robotahmid07-debug/WRO-2026-Future-Engineers-Team-Obsidian/README.md

# WRO-2026-Future-Engineers-Team-Obsidian
Official open-source repository for Team Obsidian (Bangladesh) competing in the 2026 World Robot Olympiad (WRO) Future Engineers category.

Hi,
We are Team obsidian.

in WRO 2026 we created an optimized autonomous car
