robotahmid07-debug/WRO-2026-Future-Engineers-Team-Obsidian/3d Models/LegoBevelGear-LegoBevelGearPart.SLDPRT

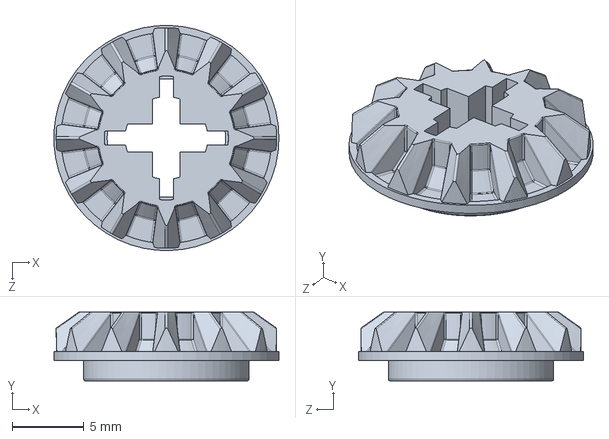
[picture p1: CAD file, 2026-08-11]
3d Models/LegoBevelGear-LegoBevelGearPart.SLDPRT
15.7 x 4.80 x 15.7 mm
