robotahmid07-debug/WRO-2026-Future-Engineers-Team-Obsidian/3d Models/2nd floor.STL

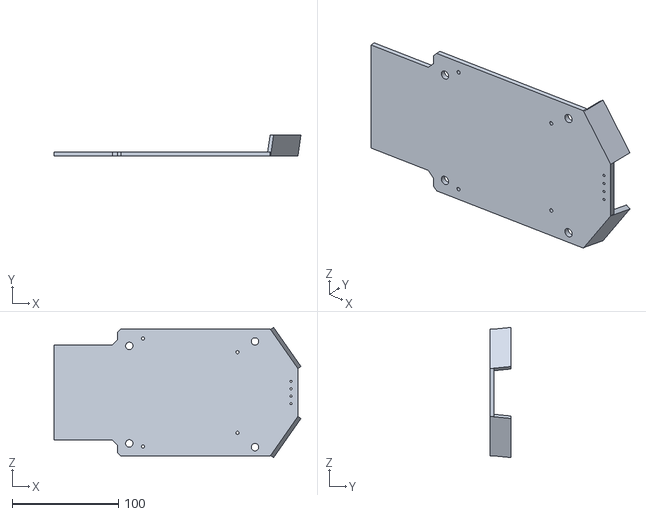
[picture p2: CAD file, 2026-08-08]
3d Models/2nd floor.STL
232.9 x 20.0 x 122.8
