robotahmid07-debug/WRO-2026-Future-Engineers-Team-Obsidian/3d Models/BackWheelAxlePartPocket.STL

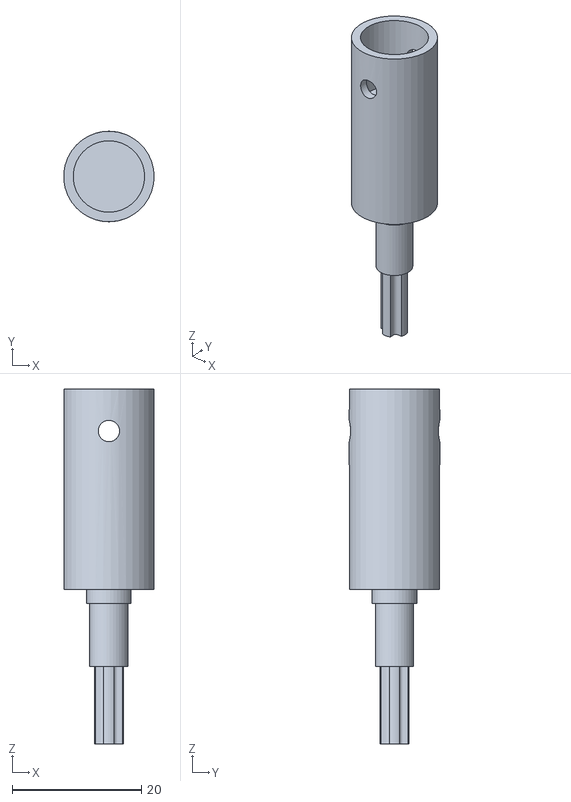
[picture p3: CAD file, 2026-08-08]
3d Models/BackWheelAxlePartPocket.STL
14.0 x 14.0 x 54.9
