robotahmid07-debug/WRO-2026-Future-Engineers-Team-Obsidian/3d Models/FrontWheelAxleLeftBody2.STL

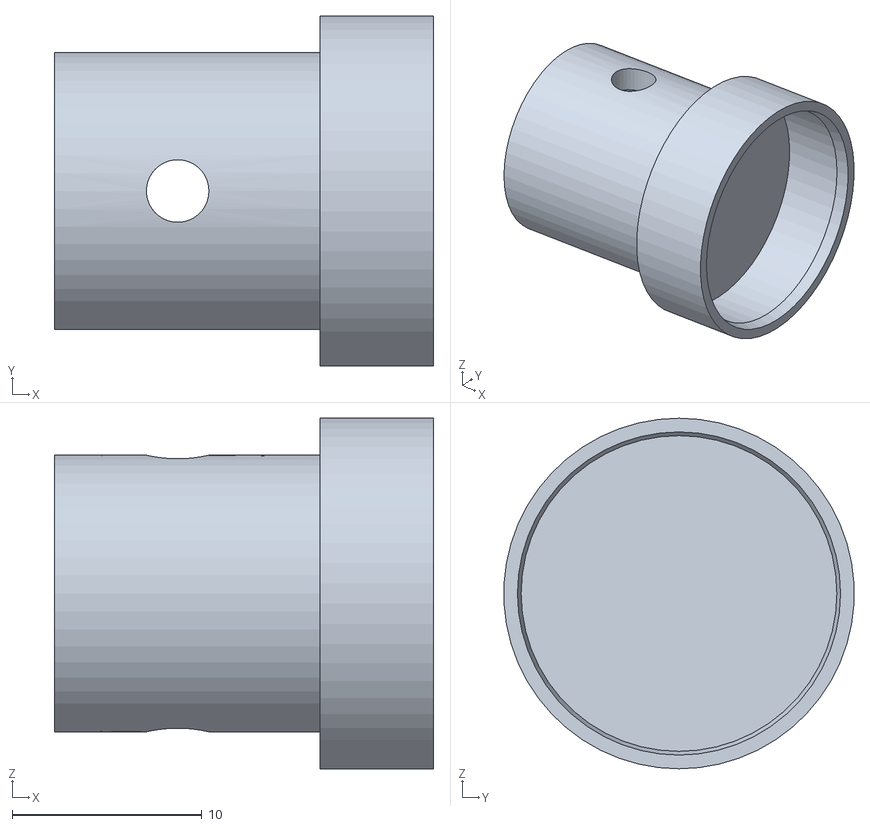
[picture p5: CAD file, 2026-08-08]
3d Models/FrontWheelAxleLeftBody2.STL
20.0 x 18.5 x 18.5
