robotahmid07-debug/WRO-2026-Future-Engineers-Team-Obsidian/3d Models/LegoDifferentialGearPart.STL

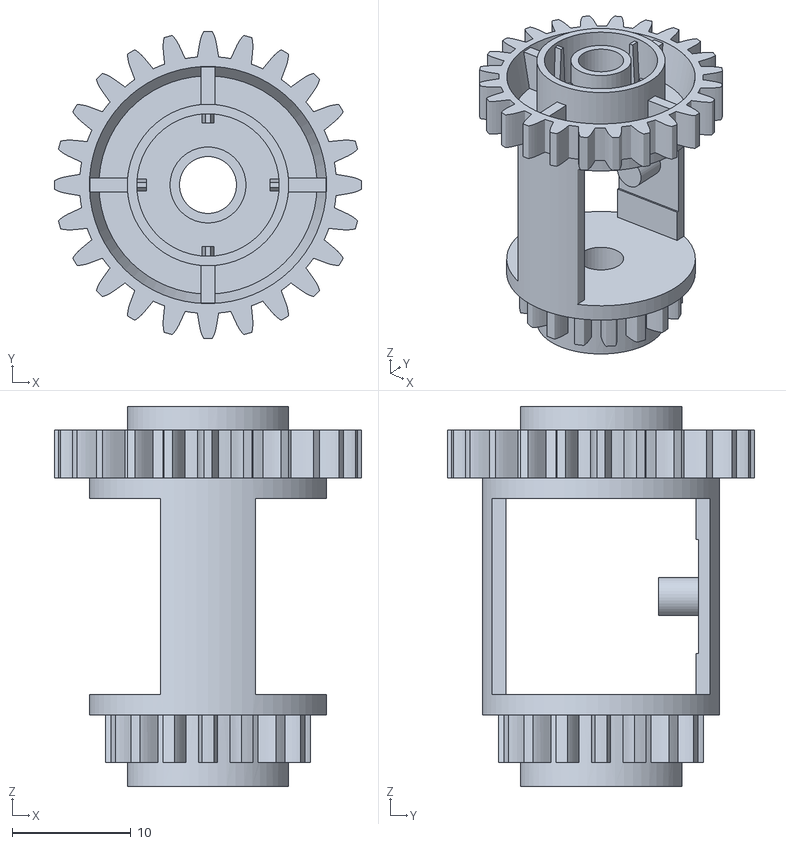
[picture p6: CAD file, 2026-08-07]
3d Models/LegoDifferentialGearPart.STL
25.9 x 25.9 x 32.0
