robotahmid07-debug/WRO-2026-Future-Engineers-Team-Obsidian/3d Models/gear cover.STL

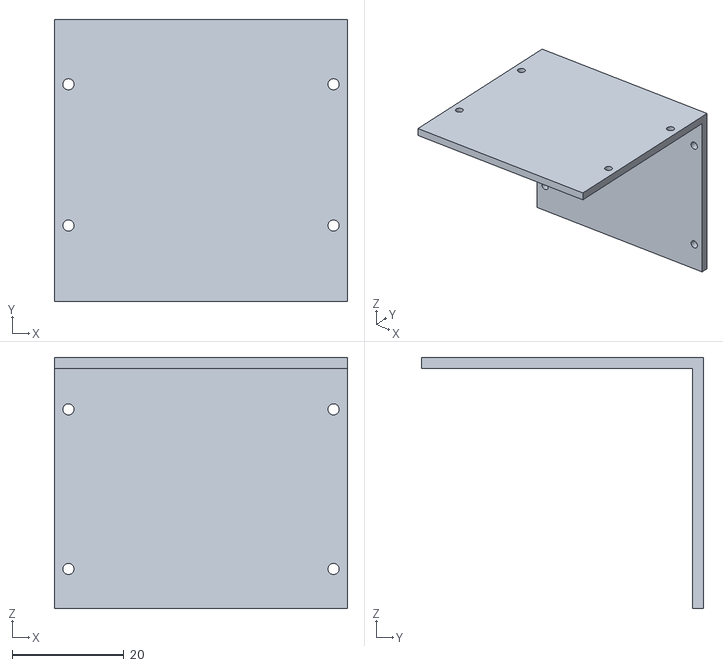
[picture p7: CAD file, 2026-08-07]
3d Models/gear cover.STL
52.5 x 50.6 x 45.0
