robotahmid07-debug/WRO-2026-Future-Engineers-Team-Obsidian/3d Models/ChassisPart.STL

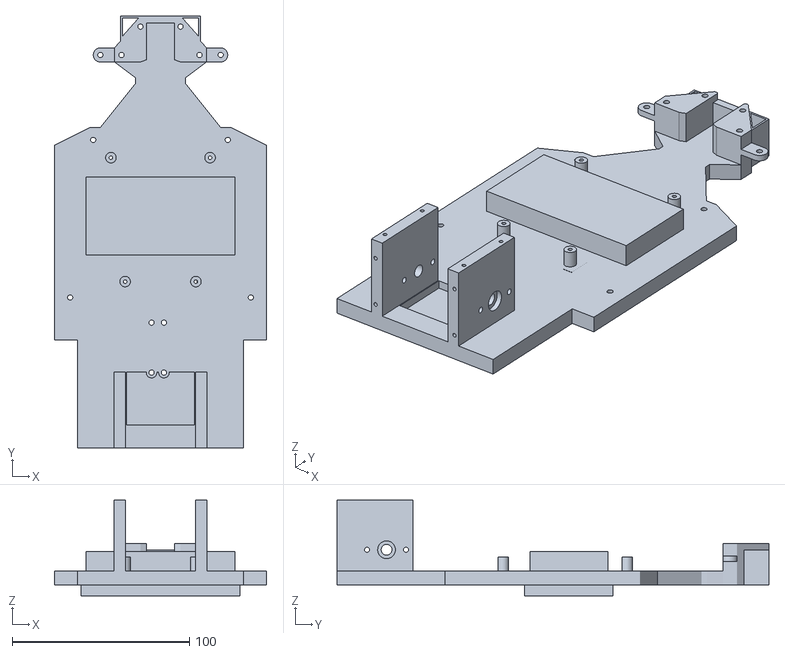
[picture p8: CAD file, 2026-08-07]
3d Models/ChassisPart.STL
120.0 x 244.0 x 54.0
