robotahmid07-debug/WRO-2026-Future-Engineers-Team-Obsidian/3d Models/huskey lens holder 16deg.STL

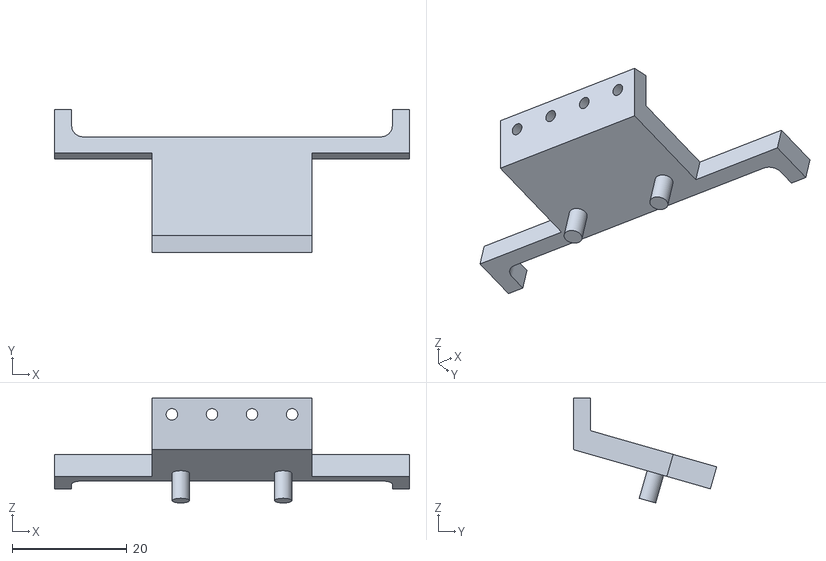
[picture p9: CAD file, 2026-08-07]
3d Models/huskey lens holder 16deg.STL
62.0 x 25.0 x 18.3
