robotahmid07-debug/WRO-2026-Future-Engineers-Team-Obsidian/3d Models/WheelLinkageBottomLeftPart.STL

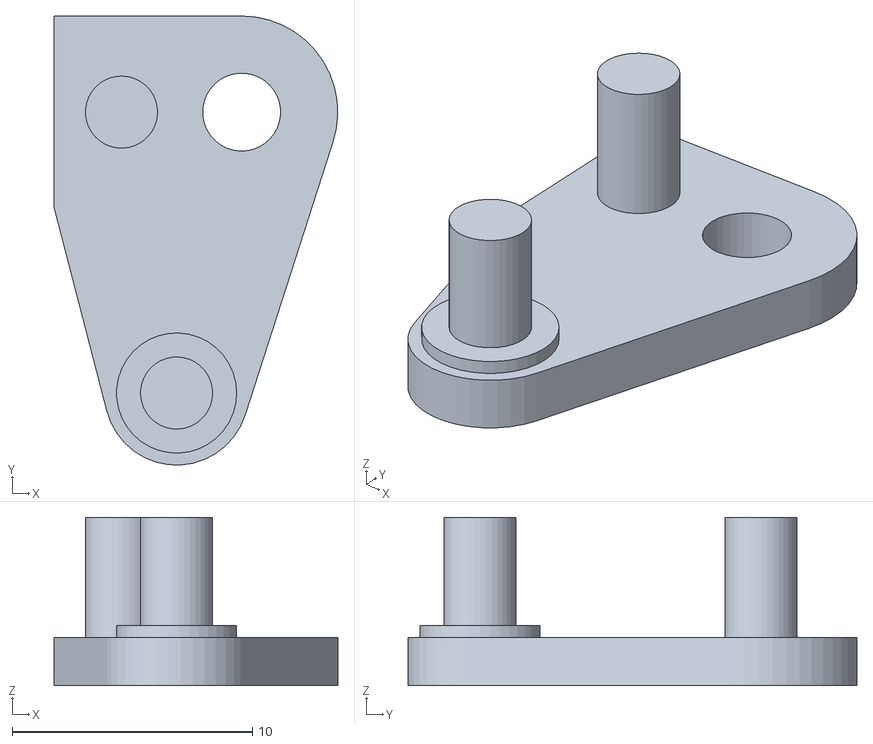
[picture p10: CAD file, 2026-08-07]
3d Models/WheelLinkageBottomLeftPart.STL
11.8 x 18.7 x 7.00
