robotahmid07-debug/WRO-2026-Future-Engineers-Team-Obsidian/3d Models/TransferLinkageLeft-TransferLinkageLeftPart.STL

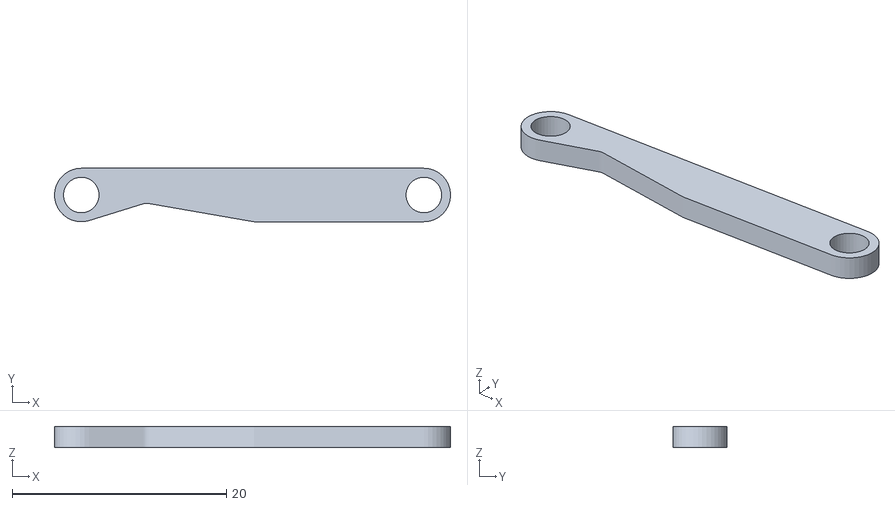
[picture p11: CAD file, 2026-08-07]
3d Models/TransferLinkageLeft-TransferLinkageLeftPart.STL
37.0 x 5.00 x 2.00
