robotahmid07-debug/WRO-2026-Future-Engineers-Team-Obsidian/3d Models/FrontWheelAxleRightBody1.STL

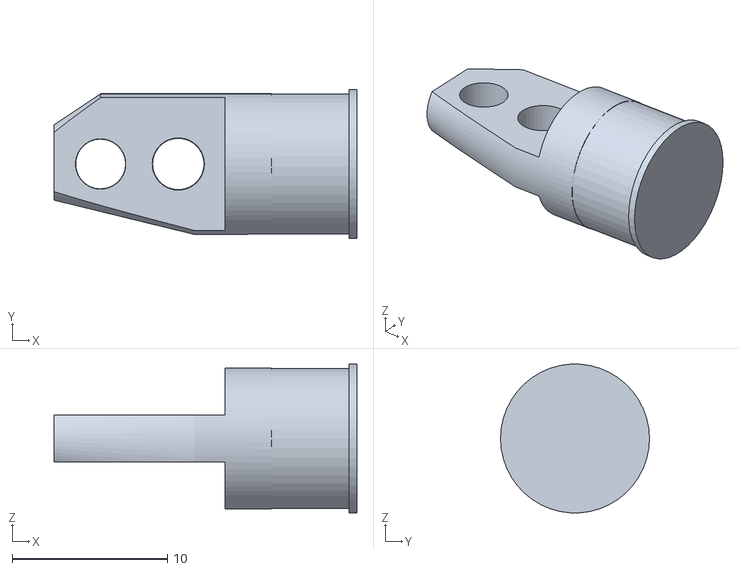
[picture p13: CAD file, 2026-08-07]
3d Models/FrontWheelAxleRightBody1.STL
19.5 x 9.59 x 9.57
