robotahmid07-debug/WRO-2026-Future-Engineers-Team-Obsidian/3d Models/huskey lens holder 12deg.STL

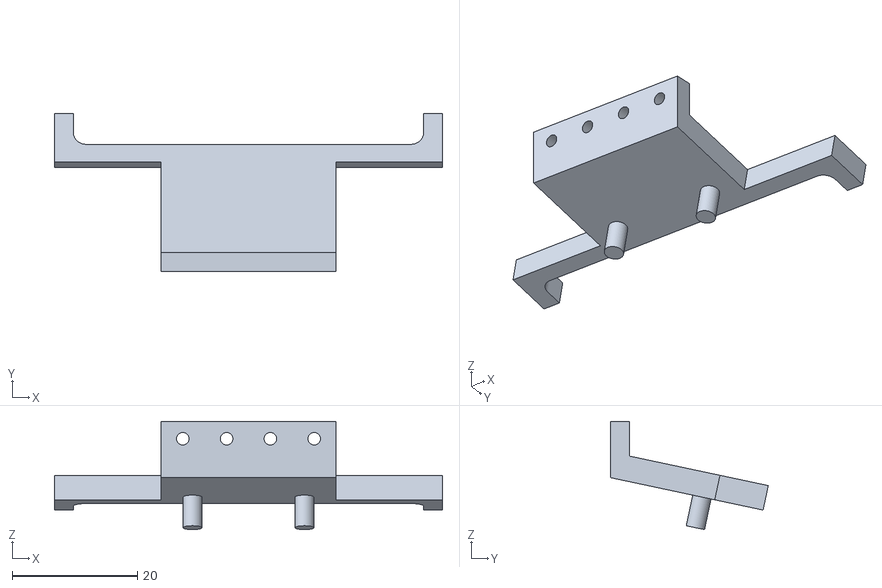
[picture p14: CAD file, 2026-08-07]
3d Models/huskey lens holder 12deg.STL
62.0 x 25.2 x 17.3
