robotahmid07-debug/WRO-2026-Future-Engineers-Team-Obsidian/3d Models/WheelLinkageTopRightPart.STL

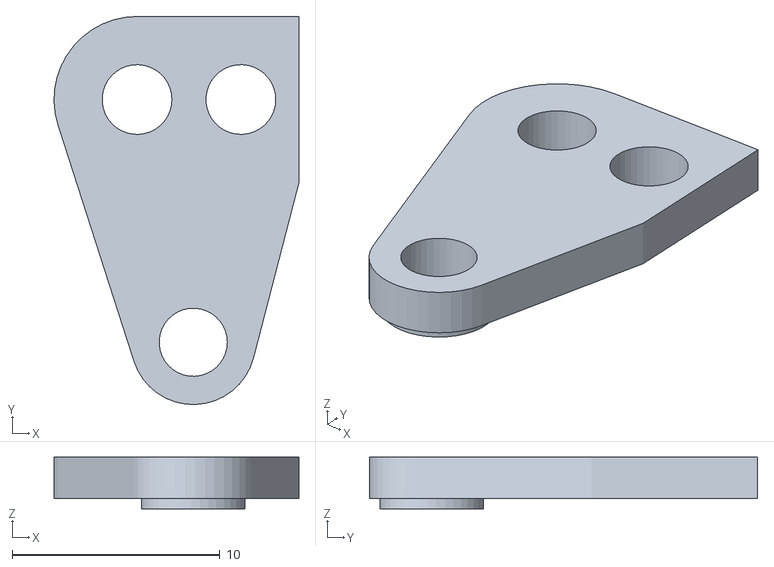
[picture p15: CAD file, 2026-08-07]
3d Models/WheelLinkageTopRightPart.STL
11.8 x 18.7 x 2.50
