robotahmid07-debug/WRO-2026-Future-Engineers-Team-Obsidian/3d Models/MotorGearPart.STL

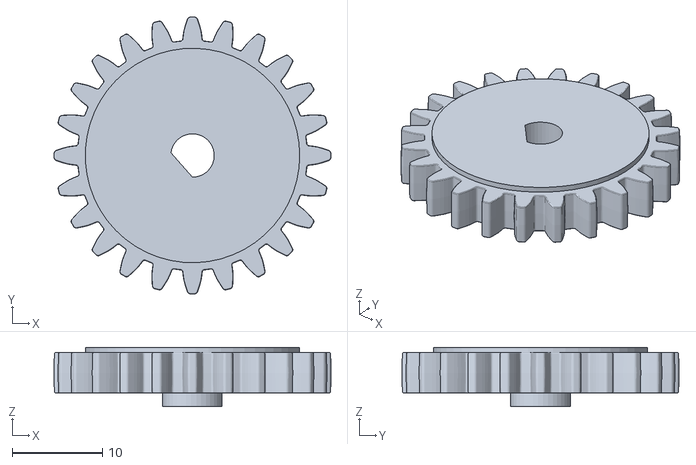
[picture p16: CAD file, 2026-08-07]
3d Models/MotorGearPart.STL
30.6 x 30.6 x 6.57
