robotahmid07-debug/WRO-2026-Future-Engineers-Team-Obsidian/3d Models/FrontWheelAxleLeftBody1.STL

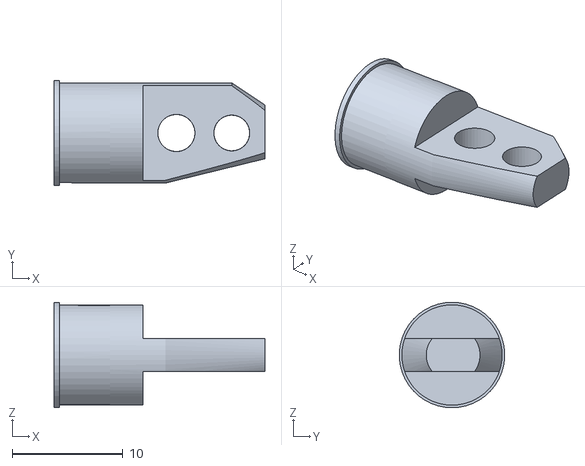
[picture p17: CAD file, 2026-08-07]
3d Models/FrontWheelAxleLeftBody1.STL
19.1 x 9.50 x 9.52
