robotahmid07-debug/WRO-2026-Future-Engineers-Team-Obsidian/3d Models/Motor Hub.STL

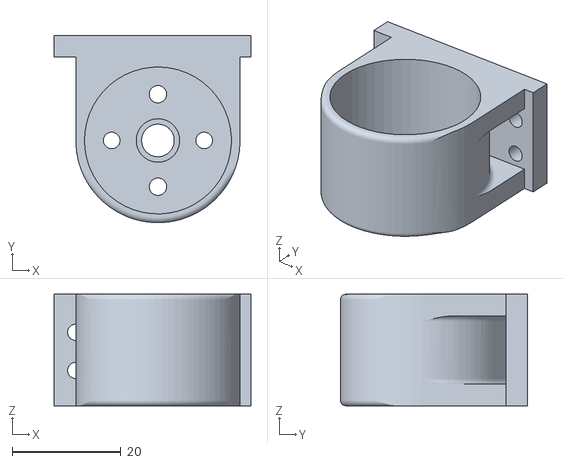
[picture p18: CAD file, 2026-08-07]
3d Models/Motor Hub.STL
36.2 x 34.4 x 20.5
