robotahmid07-debug/WRO-2026-Future-Engineers-Team-Obsidian/3d Models/Battery cover.STL

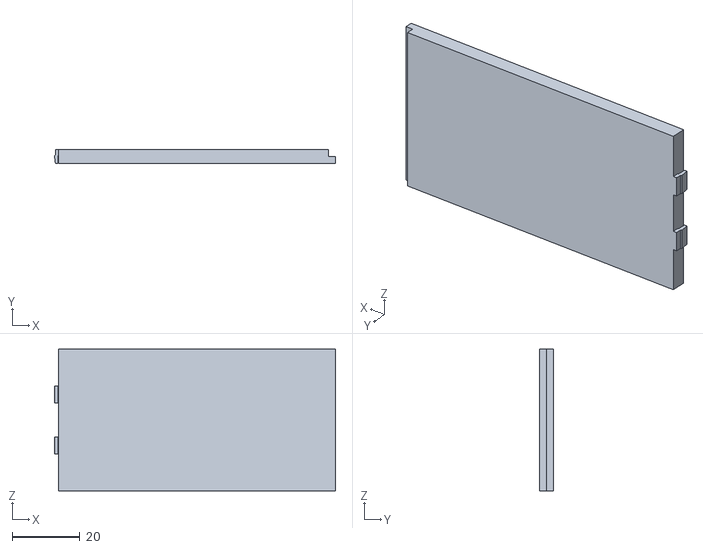
[picture p19: CAD file, 2026-08-07]
3d Models/Battery cover.STL
83.2 x 4.00 x 42.0
