robotahmid07-debug/WRO-2026-Future-Engineers-Team-Obsidian/3d Models/2nd floor piller.STL

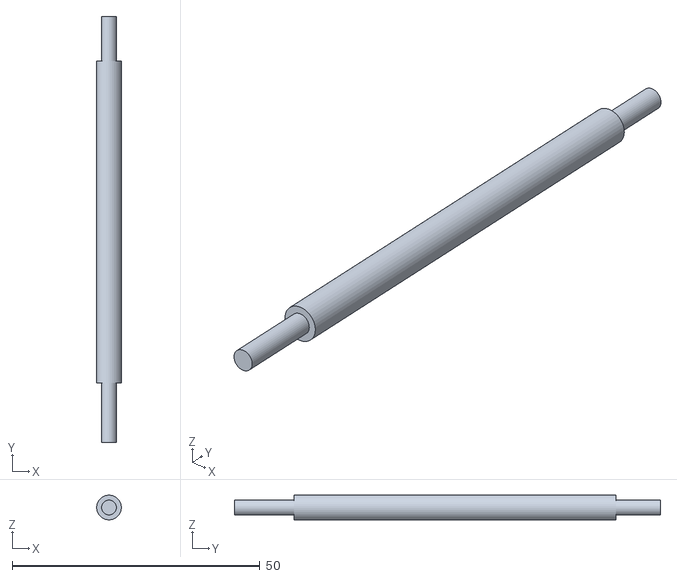
[picture p20: CAD file, 2026-08-07]
3d Models/2nd floor piller.STL
5.00 x 86.0 x 5.00
