robotahmid07-debug/WRO-2026-Future-Engineers-Team-Obsidian/3d Models/FrontCoverPart.STL

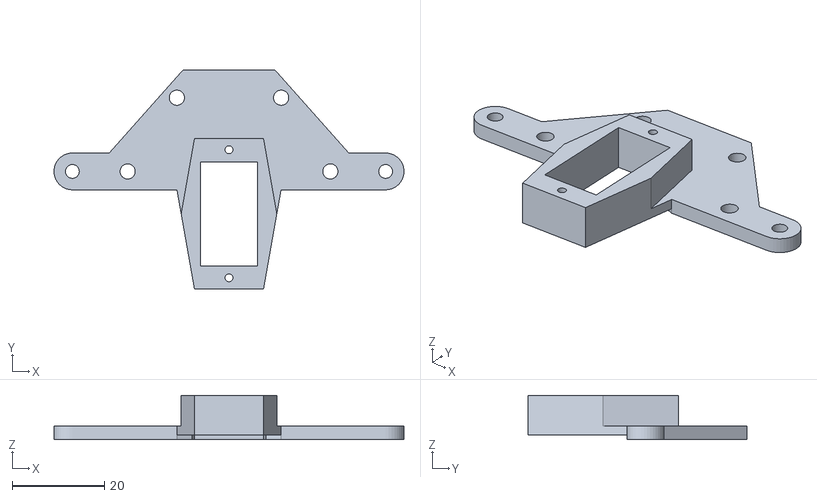
[picture p21: CAD file, 2026-08-07]
3d Models/FrontCoverPart.STL
76.0 x 47.5 x 9.65
