robotahmid07-debug/WRO-2026-Future-Engineers-Team-Obsidian/3d Models/back bearing cover.STL

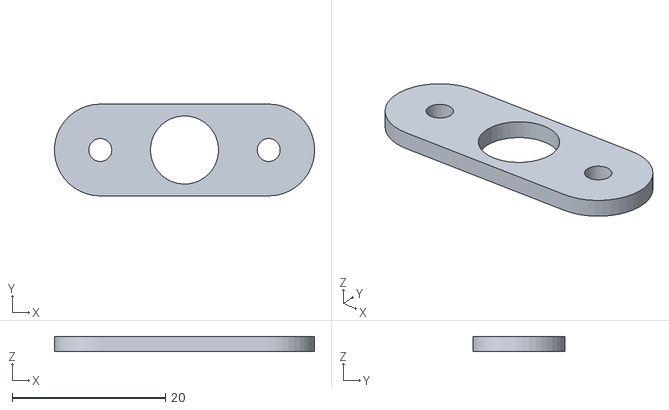
[picture p22: CAD file, 2026-08-07]
3d Models/back bearing cover.STL
34.0 x 12.0 x 2.00
