robotahmid07-debug/WRO-2026-Future-Engineers-Team-Obsidian/3d Models/TBoneLinkageBottomPart.STL

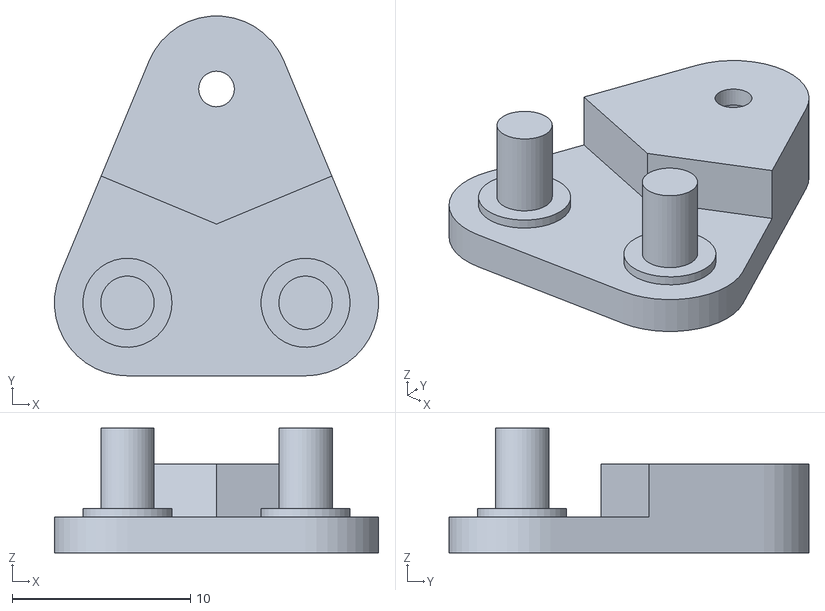
[picture p23: CAD file, 2026-08-07]
3d Models/TBoneLinkageBottomPart.STL
18.2 x 20.2 x 7.00
