robotahmid07-debug/WRO-2026-Future-Engineers-Team-Obsidian/3d Models/TBoneLinkageTopPart.STL

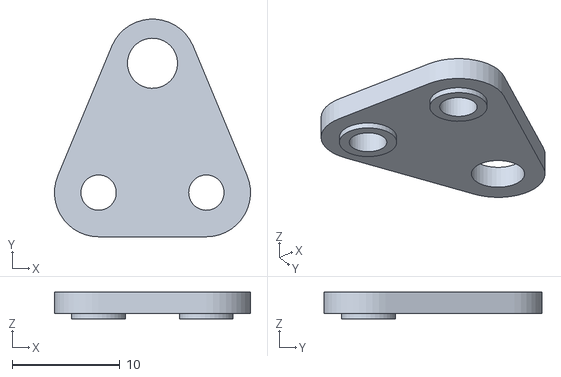
[picture p24: CAD file, 2026-08-07]
3d Models/TBoneLinkageTopPart.STL
18.2 x 20.2 x 2.50
