robotahmid07-debug/WRO-2026-Future-Engineers-Team-Obsidian/(list of files, cad)

Other CAD files:
3d Models/LegoBevelGearPart.STL
3d Models/WheelLinkageBottomRightPart.STL
3d Models/WheelLinkageTopLeftPart.STL
3d Models/TransferLinkageRightPart.STL
