robotahmid07-debug/WRO-2026-Future-Engineers-Team-Obsidian/config/system_prompt_matrix.yaml

# ==========================================
# Written by Tahmed Ahmed
# Update date : 26-7-26
# ==========================================
system_prompt_matrix:
  version: "2026.3"
  competition: "WRO Future Engineers"

  # ==========================================
  # 0. CHALLENGE SELECTION
  # ==========================================
  # This is optional – if set, it overrides the hardware switch.
  # Leave commented to use the hardware switch (GPIO 22).
  # active_challenge: "open"   # "open" or "obstacle"

  # ==========================================
  # 1. ZONE & POSE MANAGEMENT
  # ==========================================
  zone_management:
    open_challenge:
      save_start_point: True
      use_parking_slot: False
      start_pose_registration:
        method: "LIDAR_WALL_DISTANCES_AND_ODOMETRY"
        save_at_boot: True
        pose_vector: [x_start, y_start, theta_start]
      finish_behavior:
        action: "CONTROLLED_STOP_AT_START_ZONE"
        trigger: "COMPLETED_3_LAPS_AND_CROSS_START_LINE"
        deceleration_profile: "SMOOTH_BRAKE"

    obstacle_challenge:
      save_start_point: True
      use_parking_slot: True
      parking_slot_registration:
        save_initial_bay_geometry: True
        save_at_boot: True
        bay_bounding_box: [x_min, x_max, y_min, y_max]
      finish_behavior:
        action: "PARALLEL_PARKING_SEQUENCE"
        trigger: "COMPLETED_3_LAPS_AND_ENTERED_PARKING_ZONE"
        parking_routine:
          1_APPROACH: "Align parallel to saved parking bay side wall using Lidar."
          2_REVERSE_STEER: "Execute inverse Ackerman turn into the bay."
          3_ALIGN_AND_CENTER: "Adjust distance using side and rear Lidar points."
          4_FULL_STOP: "Engage motor brake and zero velocity."

  # ==========================================
  # 2. SENSOR FUSION & HOST-SIDE TRACKING
  # ==========================================
  sensor_fusion_and_tracking:
    huskylens_camera:
      i2c_bus: 1
      poll_interval: 0.05
      role: "RAW_BOUNDING_BOX_DETECTOR"
      outputs: ["COLOR_ID", "CENTROID_X", "CENTROID_Y", "WIDTH", "HEIGHT"]
      horizontal_fov_deg: 60.0

    lidar_2d:
      port: "/dev/ttyUSB1"
      baudrate: 115200
      scan_arc_deg: 90.0
      update_rate_hz: 10

    host_spatial_tracker:
      processor_location: "MAIN_ONBOARD_COMPUTER"
      coordinate_transformation:
        method: "FUSE_CAMERA_ANGLE_WITH_LIDAR_DISTANCE"
        formula: |
          Theta_rel = Camera_Centroid_To_Angle(x_px)
          R_rel = Lidar_Range_At_Angle(Theta_rel)
          Local_Coord = (R_rel * cos(Theta_rel), R_rel * sin(Theta_rel))

      spatial_gating:
        tolerance_radius_m: 0.20

      debouncing_and_persistence:
        confirmation_threshold_frames: 3
        frame_loss_tolerance_sec: 1.5
        prune_condition: "Y_LOCAL < 0.0"

      passing_priority_queue:
        sorting_rule: "SORT_BY_ASCENDING_FORWARD_DISTANCE"
        active_target: "QUEUE_INDEX_0"

  # ==========================================
  # 3. EMERGENCY ULTRASONIC BUMPER SHIELD
  # ==========================================
  ultrasonic_emergency_shield:
    enabled: True
    # ---- Feature toggles (new) ----
    enable_reverse: True                # Enable/disable reverse on critical stop
    enable_rear_check: True             # Enable/disable LIDAR rear check before reverse
    enable_hard_shield: True            # Enable/disable the 5 cm hard shield (last‑resort)
    enable_hard_steer: True             # Enable/disable hard steer + crawl when rear blocked

    thresholds_cm:
      front_stop: 12.0                  # Start reducing speed
      front_left_safety: 18.0           # Steer right if left side close
      front_right_safety: 18.0          # Steer left if right side close
      critical_stop: 8.0                # Reverse if closer than this
      hard_shield_cm: 5.0               # Last‑resort emergency threshold

    dynamic_throttle:
      enable_speed_dampening: True
      dampened_speed_factor: 0.60

    # ---- Reverse parameters (tuneable) ----
    reverse_params:
      speed_mps: -0.10                  # m/s (negative = reverse)
      duration_s: 1.0                   # seconds
      rear_clearance_threshold_m: 0.15  # meters (15 cm)

  # ==========================================
  # 4. SURPRISE TASK & DYNAMIC RULES
  # ==========================================
  traffic_light_passing_rules:
    RED_BLOCK_PASS_SIDE: "RIGHT"
    GREEN_BLOCK_PASS_SIDE: "LEFT"
    INVERT_COLORS_MID_RACE: False

  # ==========================================
  # 5. NAVIGATION & LAP COUNTING
  # ==========================================
  navigation_matrix:
    TOTAL_REQUIRED_LAPS: 3
    LAP_1_DIRECTION: "CLOCKWISE"
    LAP_2_DIRECTION: "CLOCKWISE"
    LAP_3_DIRECTION: "CLOCKWISE"

  # ==========================================
  # 6. PARKING CONFIGURATION (LIDAR-based)
  # ==========================================
  # These values are used by parking_controller.py
  # They are hardcoded in the code, but you can override them here.
  parking:
    rear_wall_target_m: 0.05           # 5 cm from rear wall
    side_wall_target_m: 0.10           # 10 cm from side wall
    alignment_tolerance_m: 0.02        # 2 cm tolerance
    approach_speed_mps: 0.10           # Speed during approach
    reverse_speed_mps: -0.12           # Speed during reverse

  # ==========================================
  # 7. STATE MACHINE EXECUTION
  # ==========================================
  state_machine:
    STATE_1_INIT:
      - Register starting pose $(X_0, Y_0, \theta_0)$ via Lidar.
      - If Challenge == "OBSTACLE": Register parking slot dimensions.
      - Reset lap counter to 0.

    STATE_2_NAVIGATE:
      - Run Host Spatial Tracker (HuskyLens raw bounding box + Lidar fusion).
      - Check Ultrasonic Emergency Shield:
          - If Distance < `front_stop`: Reduce speed and steer according to traffic rule.
          - If Distance < `critical_stop`: Reverse briefly then continue.
          - If Distance < `front_left_safety` / `front_right_safety`: Steer away.
      - Maintain persistent map and filter out vision drops/flickers.
      - Steer vehicle relative to `active_target` (`RED` -> Right, `GREEN` -> Left).
      - Track lap completion via LIDAR corner detection + odometry fallback.

    STATE_3_TERMINATION:
      - If Challenge == "OPEN" and Laps == 3:
          - Target saved `start_pose` and perform smooth deceleration to full stop.
      - If Challenge == "OBSTACLE" and Laps == 3:
          - Navigate to saved `parking_slot_geometry` and trigger 4-stage Parallel Parking sequence using LIDAR 360°.

  # ==========================================
  # NAVIGATION BEHAVIOR (Open & Obstacle Challenges)
  # ==========================================
  navigation:
    # ---- Direction mode (NEW) ----
    direction_mode: "auto"        # "switch" = read DIRECTION_SELECT GPIO (manual)
                                  # "auto"   = infer from LIDAR asymmetry at startup
    auto_direction_scan_window_deg: 60
    auto_direction_min_confidence_m: 0.15

    # ---- Speed control parameters (NEW) ----
    cruise_speed_mps: 1.7                 # target speed on straights
    max_accel_mps2: 2.5                   # maximum acceleration (m/s²)
    max_decel_mps2: 3.5                   # maximum deceleration for braking (m/s²)
    enable_lookahead_braking: true        # toggle look‑ahead corner braking
    corner_strength_ref: 0.35             # reference corner strength for scaling

    # ---- Open Challenge (fast, aggressive) ----
    open_challenge:
      base_speed_mps: 1.5
      wall_follow_gain: 0.30            # More aggressive centering
      steer_magnitude_radps: 0.35       # Sharper turns
      straight_boost_factor: 1.20       # 20% boost on straights
      corner_slowdown_max_reduction: 0.3 # Max speed reduction from steering intensity
      predictive_slowdown_gain: 0.3     # Gain for derivative‑based slowdown

      # ---- PID wall‑following gains ----
      pid:
        kp: 2.2          # was 25.0 – normalised error scale
        ki: 0.02         # was 0.1
        kd: 0.9          # was 8.0

      # ---- Corner detection ----
      corner_detection:
        use_derivative: True            # Enable derivative‑based detection
        use_percentage: True            # Enable 40% percentage detection
        use_graded_steering: True       # Enable graded steering (partial → full)
        use_imu_confirmation: True      # Enable IMU confirmation
        lidar_derivative_threshold: 0.3 # m/s change – sensitivity
        pct_threshold: 0.4              # 40% change threshold
        imu_confirm_threshold_radps: 0.3 # rad/s – IMU confirmation

      # ---- G‑force limiting ----
      g_force:
        max_safe_g: 0.30                # Maximum lateral G before speed reduction
        filter_alpha: 0.3               # Low‑pass filter coefficient

    # ---- Obstacle Challenge (more conservative) ----
    obstacle_challenge:
      base_speed_mps: 1.3
      wall_follow_gain: 0.25
      steer_magnitude_radps: 0.30
      straight_boost_factor: 1.10
      corner_slowdown_max_reduction: 0.4
      predictive_slowdown_gain: 0.4

      # ---- PID wall‑following gains ----
      pid:
        kp: 2.2          # was 25.0 – normalised error scale
        ki: 0.02         # was 0.1
        kd: 0.9          # was 8.0

      # ---- Corner detection ----
      corner_detection:
        use_derivative: True
        use_percentage: True
        use_graded_steering: True
        use_imu_confirmation: True
        lidar_derivative_threshold: 0.25
        pct_threshold: 0.4
        imu_confirm_threshold_radps: 0.3

      # ---- G‑force limiting ----
      g_force:
        max_safe_g: 0.28                # Slightly lower for safety
        filter_alpha: 0.3

      # ---- Traffic light specific (Obstacle only) ----
      traffic_light:
        distance_slowdown_start_m: 2.0
        distance_slowdown_min_factor: 0.4
        steering_slowdown_max_reduction: 0.4
        lidar_confirm_range_m: 2.5

  # ==========================================
  # MAPPING CONFIGURATION
  # ==========================================
  mapping:
    use_mapping: True
    save_map_to_disk: True
    load_map_from_disk: True
    force_rebuild: False

  # ==========================================
  # SURPRISE RULE
  # ==========================================
  surprise_rule:
    enabled: True
    trigger_lap: 2
    color_to_continue: "GREEN"
    color_to_reverse: "RED"
    fallback_direction: "REVERSE"
    turnaround_speed: 0.1               # m/s during U‑turn

  # ==========================================
  # LAP COUNTING
  # ==========================================
  lap_counting:
    lap_length_m: 12.0
    section_fallback_timeout_s: 3.0
    emergency_lap_margin_m: 0.2

  # ==========================================
  # VEHICLE PHYSICAL PARAMETERS
  # ==========================================
  vehicle:
    wheelbase_m: 0.20
    max_speed_mps: 1.5                  # Absolute hard limit (never exceed this)
    max_steer_rad: 0.524                # 30°

  # ==========================================
  # VISION (HuskyLens)
  # ==========================================
  vision:
    color_red_id: 1
    color_green_id: 2
