robotahmid07-debug/WRO-2026-Future-Engineers-Team-Obsidian/(commit log)

2026-07-21 Create sample files
2026-07-28 Create husky ai camera lens 2
2026-07-29 Update husky ai camera lens 2
2026-08-01 Create how to calibrate without internet
2026-08-01 Create PCB
2026-08-01 Create Power_and_thermals
2026-08-01 Create PCB_Garbar
2026-08-03 Update: Adding pin out map for Raspberry Pi 5
    Added Raspberry Pi 5 pinout mapping with signal types.
2026-08-03 Update Pinout Mapping for Raspberry Pi 5 and ESP32-S3
    Expanded pinout mapping for Raspberry Pi 5, ESP32-S3, BNO086 IMU, BTS7960 Motor Driver, and Steering Servo. Added detailed connections and protocols for each component.
2026-08-04 Create lidar
2026-08-05 fixing a wire connection
2026-08-05 Update Circuit_diagram_V1.svg : making big
2026-08-05 Create lidar piller filter guide
2026-08-07 fixing GND connection
2026-08-07 Refactor schematic connections and update coordinates
2026-08-08 Create sample file
2026-08-13 Fix pinout mapping for switches
    Corrected connection points and logic states for Switch_1, Switch_2, and Switch_3 in the pinout mapping.
2026-08-13 Update Power_and_thermals
